SWCCCC/laser-auto-aim-system/25e/docs/images/视觉追踪部分.jpg

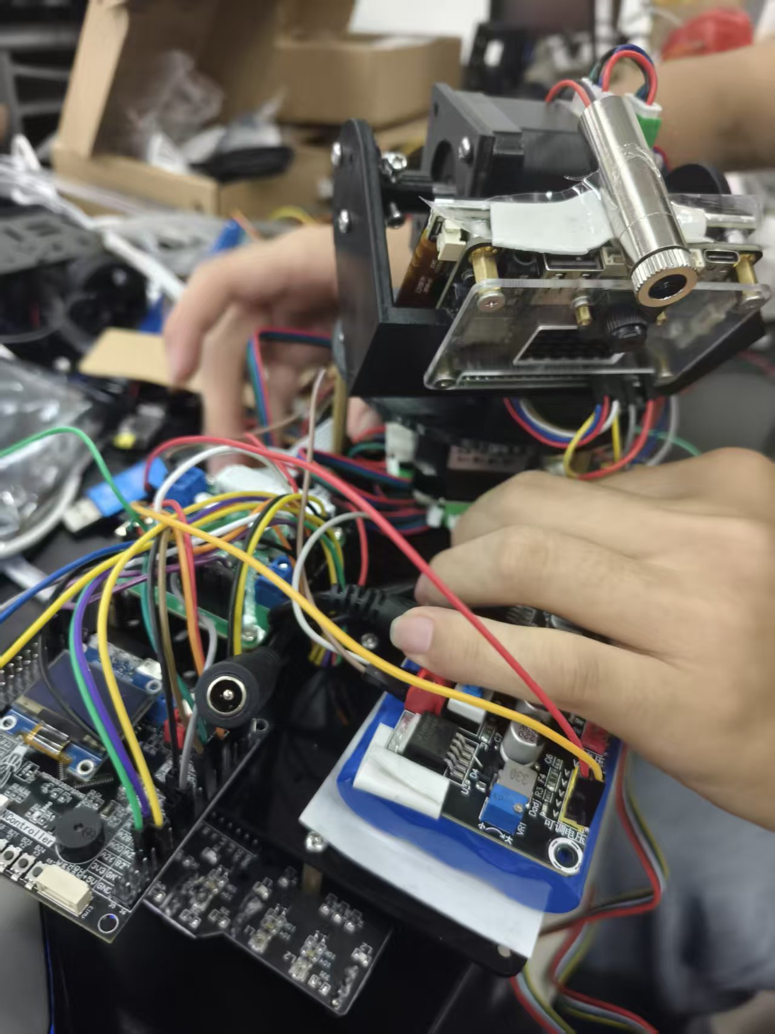
25e/docs/images/视觉追踪部分.jpg
