SWCCCC/laser-auto-aim-system/README.md

# laser-auto-aim-system
基于机器视觉与嵌入式控制的自动瞄准系统，实现对目标靶的自动识别与激光瞄准。 项目来源于2025年全国大学生电子设计竞赛E题。
